GrantTrebbin/60V-300mA-LED-Driver/README.md

# 60V-300ma-LED-Driver

Design of a 12 V to 60 V 300 mA DC-DC converter to power an LED panel
