GrantTrebbin/60V-300mA-LED-Driver/DC_DC_Boost.pdf

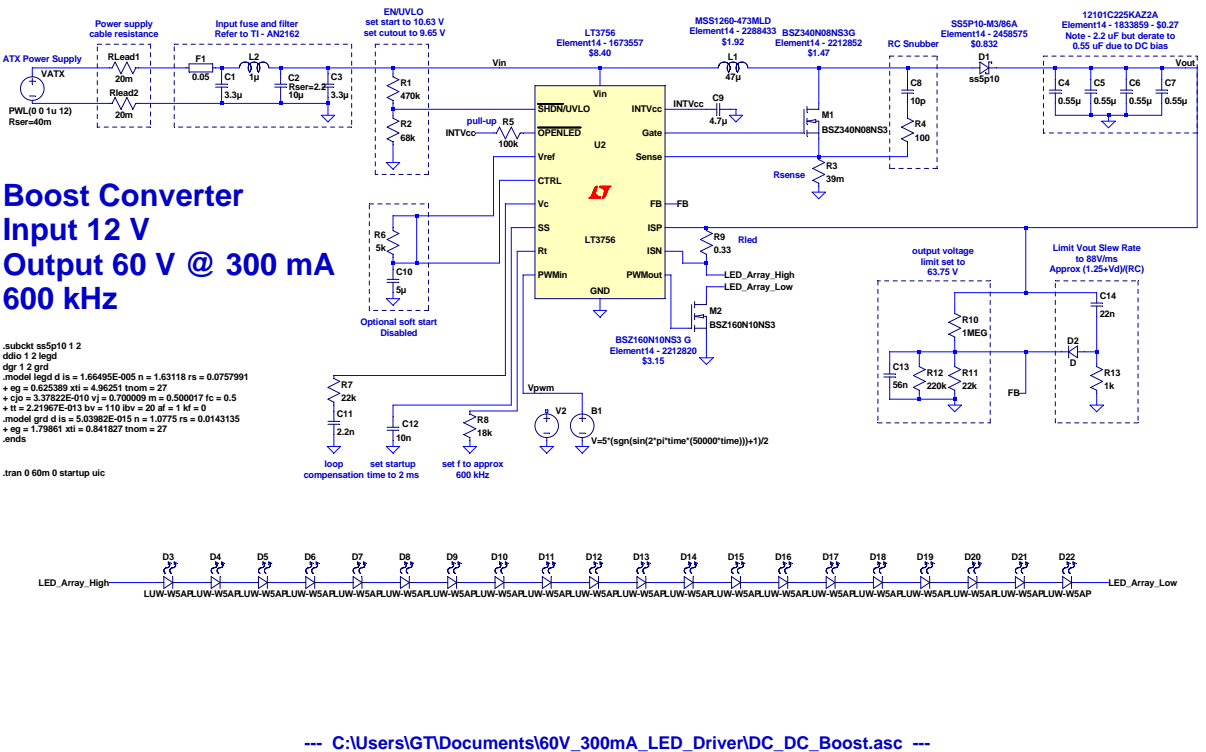
[picture p1: page 1]

12101C225KAZ2A
Element14 - 1833859 - $0.27
Note - 2.2 uF but derate to
0.55 uF due to DC bias

Input fuse and filter
Refer to TI - AN2162

Limit Vout Slew Rate
Approx (1.25+Vd)/(RC)

.subckt ss5p10 1 2
ddio 1 2 legd
dgr 1 2 grd
.model legd d is = 1.66495E-005 n = 1.63118 rs = 0.0757991
+ eg = 0.625389 xti = 4.96251 tnom = 27
+ cjo = 3.37822E-010 vj = 0.700009 m = 0.500017 fc = 0.5
+ tt = 2.21967E-013 bv = 110 ibv = 20 af = 1 kf = 0
.model grd d is = 5.03982E-015 n = 1.0775 rs = 0.0143135
+ eg = 1.79861 xti = 0.841827 tnom = 27
.ends

V=5*(sgn(sin(2*pi*time*(50000*time)))+1)/2

--- C:\Users\GT\Documents\60V_300mA_LED_Driver\DC_DC_Boost.asc ---
