GrantTrebbin/60V-300mA-LED-Driver/resonanceTest.asc

C1: cap; 0.1n
D1: diode; Dideal
D2: diode
L1: ind; 12µ; Rser=20m
R1: res; 10m
S1: sw
V1: voltage; 12
V2: voltage; 52.9
V3: voltage; PULSE(0 5 0 1n 1n 1.7u 2.55u)
Named nets: 0
.model SW SW(Ron=0.01 Roff=1G Vt=0 Vh=-.5 Lser=0 Vser=0)
.tran 0 10m 0 1n
.model Dideal D(Ron=0.01 Roff=1G Vfwd=0.465)
