GrantTrebbin/60V-300mA-LED-Driver/LEDEquivalentTest.asc

D1: LED; LUW-W5AP
D2: LED; LUW-W5AP
D3: LED; LUW-W5AP
D4: LED; LUW-W5AP
D5: LED; LUW-W5AP
D6: LED; LUW-W5AP
D7: LED; LUW-W5AP
D8: LED; LUW-W5AP
D9: LED; LUW-W5AP
D10: LED; LUW-W5AP
D11: LED; LUW-W5AP
D12: LED; LUW-W5AP
D13: LED; LUW-W5AP
D14: LED; LUW-W5AP
D15: LED; LUW-W5AP
D16: LED; LUW-W5AP
D17: LED; LUW-W5AP
D18: LED; LUW-W5AP
D19: LED; LUW-W5AP
D20: LED; LUW-W5AP
I1: current; 0.1
Named nets: 0
.dc I1 0 0.3 0.001
