GrantTrebbin/60V-300mA-LED-Driver/DC_DC_Boost.asc

B1: bv; V=5*(sgn(sin(2*pi*time*(50000*time)))+1)/2
C1: cap; 3.3µ; Rser=10
C2: cap; 10µ
C3: cap; 3.3µ; V=25 Irms=0 Rser=0.005 Lser=0 mfg="TDK" pn="C4532X7RlE335M" type="X7R"
C4: cap; 0.55µ; Rser=0.05
C5: cap; 0.55µ
C6: cap; 0.55µ
C7: cap; 0.55µ; Rser=0.05
C8: cap; 10p
C9: cap; 4.7µ
C10: cap; 5µ
C11: cap; 2.2n
C12: cap; 10n
C13: cap; 56n
C14: cap; 22n
D1: schottky; ss5p10
D2: diode
D3: LED; LUW-W5AP
D4: LED; LUW-W5AP
D5: LED; LUW-W5AP
D6: LED; LUW-W5AP
D7: LED; LUW-W5AP
D8: LED; LUW-W5AP
D9: LED; LUW-W5AP
D10: LED; LUW-W5AP
D11: LED; LUW-W5AP
D12: LED; LUW-W5AP
D13: LED; LUW-W5AP
D14: LED; LUW-W5AP
D15: LED; LUW-W5AP
D16: LED; LUW-W5AP
D17: LED; LUW-W5AP
D18: LED; LUW-W5AP
D19: LED; LUW-W5AP
D20: LED; LUW-W5AP
D21: LED; LUW-W5AP
D22: LED; LUW-W5AP
F1: EuropeanResistor; 0.05
L1: ind; 47µ; Ipk=3.3 Rser=0.075 Rpar=4427.4 Cpar=0 mfg="Coilcraft" pn="MSS1260-473"
L2: ind; 1µ
M1: nmos; BSZ340N08NS3
M2: nmos; BSZ160N10NS3
R1: res; 0.4
R2: res; 470k
R3: res; 68k
R4: res; 39m
R5: res; 100
R6: res; 100k
R7: res; 5k
R8: res; 22k
R9: res; 18k
R10: res; 0.33
R11: res; 1MEG
R12: res; 22k
R13: res; 220k
R14: res; 1k
RLead1: res; 20m
Rlead2: res; 20m
U1: LT3756
V2: voltage; 5
VATX: voltage; PWL(0 0 1u 12); Rser=40m
Named nets: 0, INTVcc, LED_Array_High, LED_Array_Low, Vout, FB, Vin, Vpwm
EN/UVLO 
set start to 10.63 V
set cutout to 9.65 V
.tran 0 60m 0 startup uic
Boost Converter
Input 12 V
Output 60 V @ 300 mA
600 kHz
set f to approx
600 kHz
set startup
time to 2 ms
loop
compensation
pull-up
output voltage
limit set to
63.75 V
MSS1260-473MLD
Element14 - 2288433
$1.92
BSZ340N08NS3G
Element14 - 2212852
$1.47
SS5P10-M3/86A
Element14 - 2458575
$0.832
12101C225KAZ2A
Element14 - 1833859 - $0.27
Note - 2.2 uF but derate to
0.55 uF due to DC bias
LT3756
Element14 - 1673557
$8.40
.subckt ss5p10 1 2
ddio 1 2 legd
dgr 1 2 grd
.model legd d is = 1.66495E-005 n = 1.63118 rs = 0.0757991
+ eg = 0.625389 xti = 4.96251 tnom = 27
+ cjo = 3.37822E-010 vj = 0.700009 m = 0.500017 fc = 0.5
+ tt = 2.21967E-013 bv = 110 ibv = 20 af = 1 kf = 0
.model grd d is = 5.03982E-015 n = 1.0775 rs = 0.0143135
+ eg = 1.79861 xti = 0.841827 tnom = 27
.ends
ATX Power Supply
Power supply
cable resistance
Input fuse and filter
Refer to TI - AN2162
RC Snubber
Limit Vout Slew Rate
to 88V/ms
Approx (1.25+Vd)/(RC)
Rsense
Rled
Optional soft start
Disabled
BSZ160N10NS3 G
Element14 - 2212820
$3.15
