GrantTrebbin/60V-300mA-LED-Driver/PCB/60V_300mA_LED_Driver.sch

## KiCad design PCB/60V_300mA_LED_Driver.sch (2015-04-28)

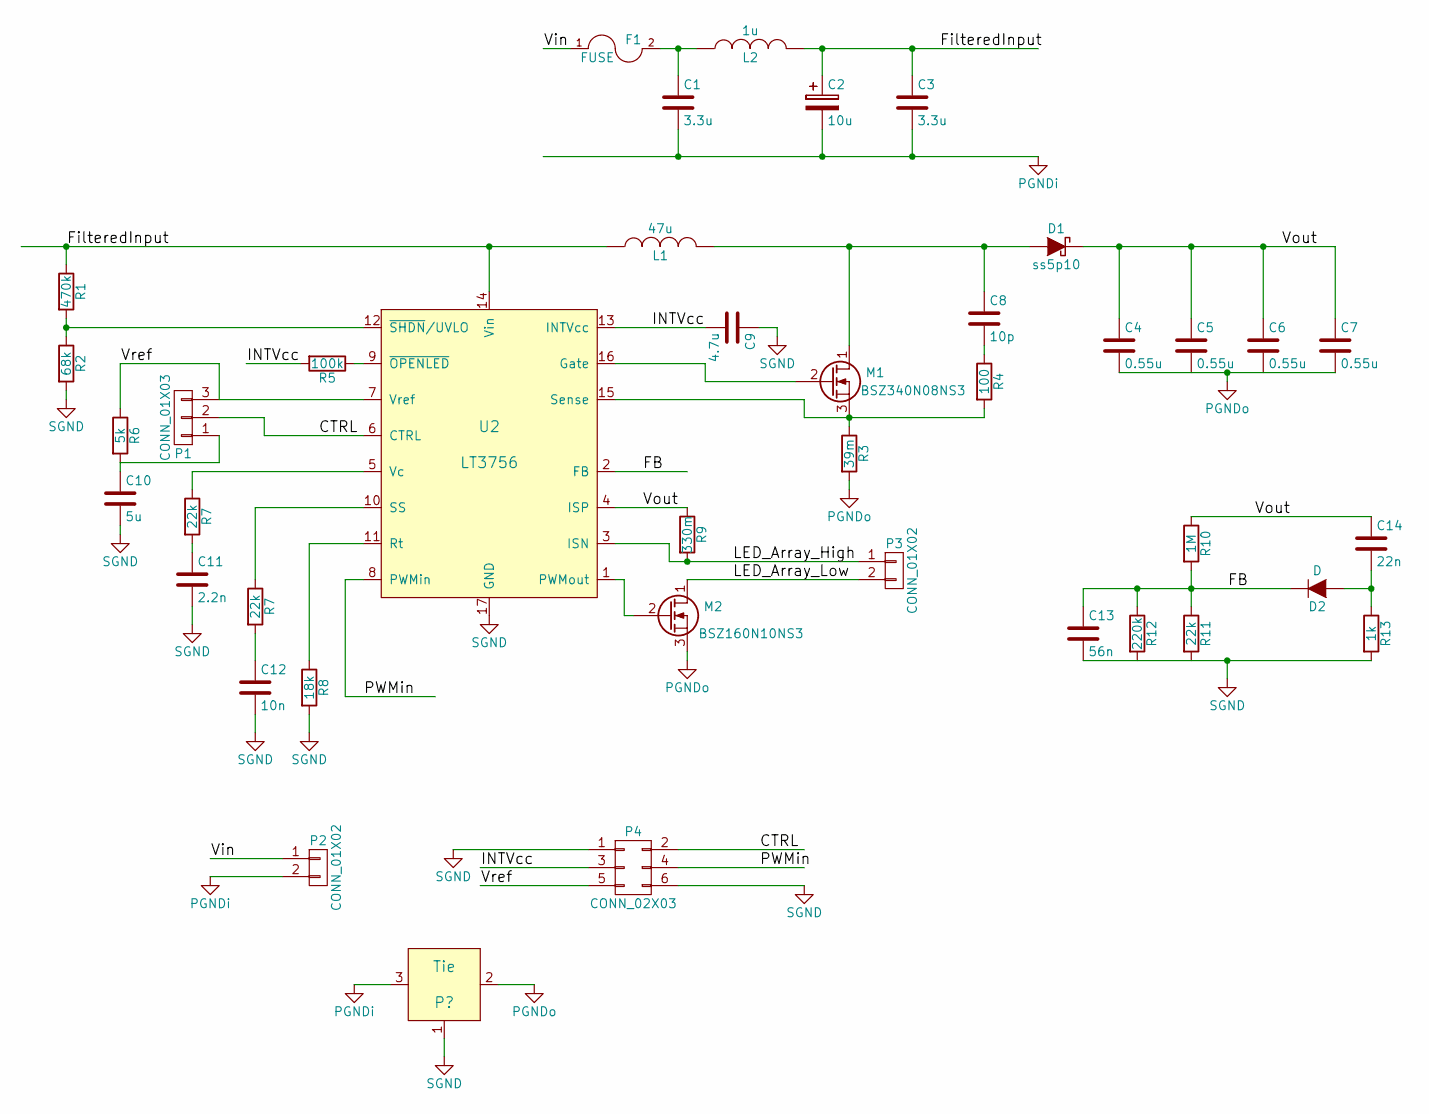
[picture p2: schematic 60V_300mA_LED_Driver.sch]

Parts:
C1, C3: 3.3u
C2: 10u
C4, C5, C6, C7: 0.55u
C8: 10p
C9: 4.7u
C10: 5u
C11: 2.2n
C12: 10n
C13: 56n
C14: 22n
D1: ss5p10
D2: D
F1: FUSE
L1: 47u
L2: 1u
M1: BSZ340N08NS3
M2: BSZ160N10NS3
P1: CONN_01X03
P2, P3: CONN_01X02
P4: CONN_02X03
R1: 470k
R2: 68k
R3: 39m
R4: 100
R5: 100k
R6: 5k
R7, R11: 22k
R8: 18k
R9: 330m
R10: 1M
R12: 220k
R13: 1k
U2: LT3756

Connections:
CTRL: P1.2, P4.2, U2.6 (CTRL)
FB: C13.1, D2.2 (K), R10.2, R11.1, R12.1, U2.2 (FB)
FilteredInput: C2.1, C3.1, L1.1, L2.2, R1.1, U2.14 (Vin)
INTVcc: C9.2, P4.3, R5.2, U2.13 (INTVcc)
LED_Array_High: P3.1, R9.2, U2.3 (ISN)
LED_Array_Low: M2.1 (D), P3.2
unnamed: C1.1, F1.2, L2.1
unnamed: C8.1, D1.1 (A), L1.2, M1.1 (D)
unnamed: C8.2, R4.1
unnamed: C10.1, P1.1, R6.2
unnamed: C11.1, R7.2
unnamed: C12.1, R7.2
unnamed: C14.2, D2.1 (A), R13.1
unnamed: M1.2 (G), U2.16 (Gate)
unnamed: M1.3 (S), R3.1, R4.2, U2.15 (Sense)
unnamed: M2.2 (G), U2.1 (PWMout)
unnamed: R1.2, R2.1, U2.12 (~SHDN~/UVLO)
unnamed: R5.1, U2.9 (~OPENLED)
unnamed: R7.1, U2.5 (Vc), U2.10 (SS)
unnamed: R8.1, U2.11 (Rt)
PGNDi: C1.2, C2.2, C3.2, P2.2
PGNDo: C4.2, C7.2, M2.3 (S), R3.2
PWMin: P4.4, U2.8 (PWMin)
SGND: C9.1, C10.2, C11.2, C12.2, C13.2, P4.1, P4.6, R2.2, R8.2, R13.2, U2.17 (GND)
Vin: F1.1, P2.1
Vout: C4.1, C5.1, C6.1, C7.1, C14.1, D1.2 (K), R9.1, R10.1, U2.4 (ISP)
Vref: P1.3, P4.5, R6.1, U2.7 (Vref)
