GrantTrebbin/60V-300mA-LED-Driver/(commit log)

2015-01-12 Create a file to simulate an LED equivalent
    When designing the switch-mode LED driver, a model of
    the load is required. This file allows the model to be compared
    with measured data.
2015-01-13 Create LED Equivalent Model
    Simulate 20 LUW-W5AP LEDs from LTSpice to verify that
    the I-V curve matches measured data from the LED panel
2015-01-20 Create a preliminary model of a boost converter
    Model a 60 V 300 mA supply using an LT3761
2015-01-30 Add PWM Control and Increase Stability
    Add voltage sources to control Analog and Digital dimming.
    Change compensation network to stop overshoot on startup.
2015-02-10 Add soft start capabilities to the converter and simulate resonance
    Explore different methods of soft starting the DC DC converter and simulate a resonance phenomena related to the parasitic capacitance of the MOSFET.
2015-03-16 Finalize design before moving to KiCad
2015-04-28 Start up of PCB design in Kicad
    [60V_300mA_LED_Driver.sch]
